yopocho/ESP32_Weather_API/README.md

Repository for creating a new kind of weatherstation for people who are dead-blind.
