yopocho/ESP32_Weather_API/Schematic.pdf

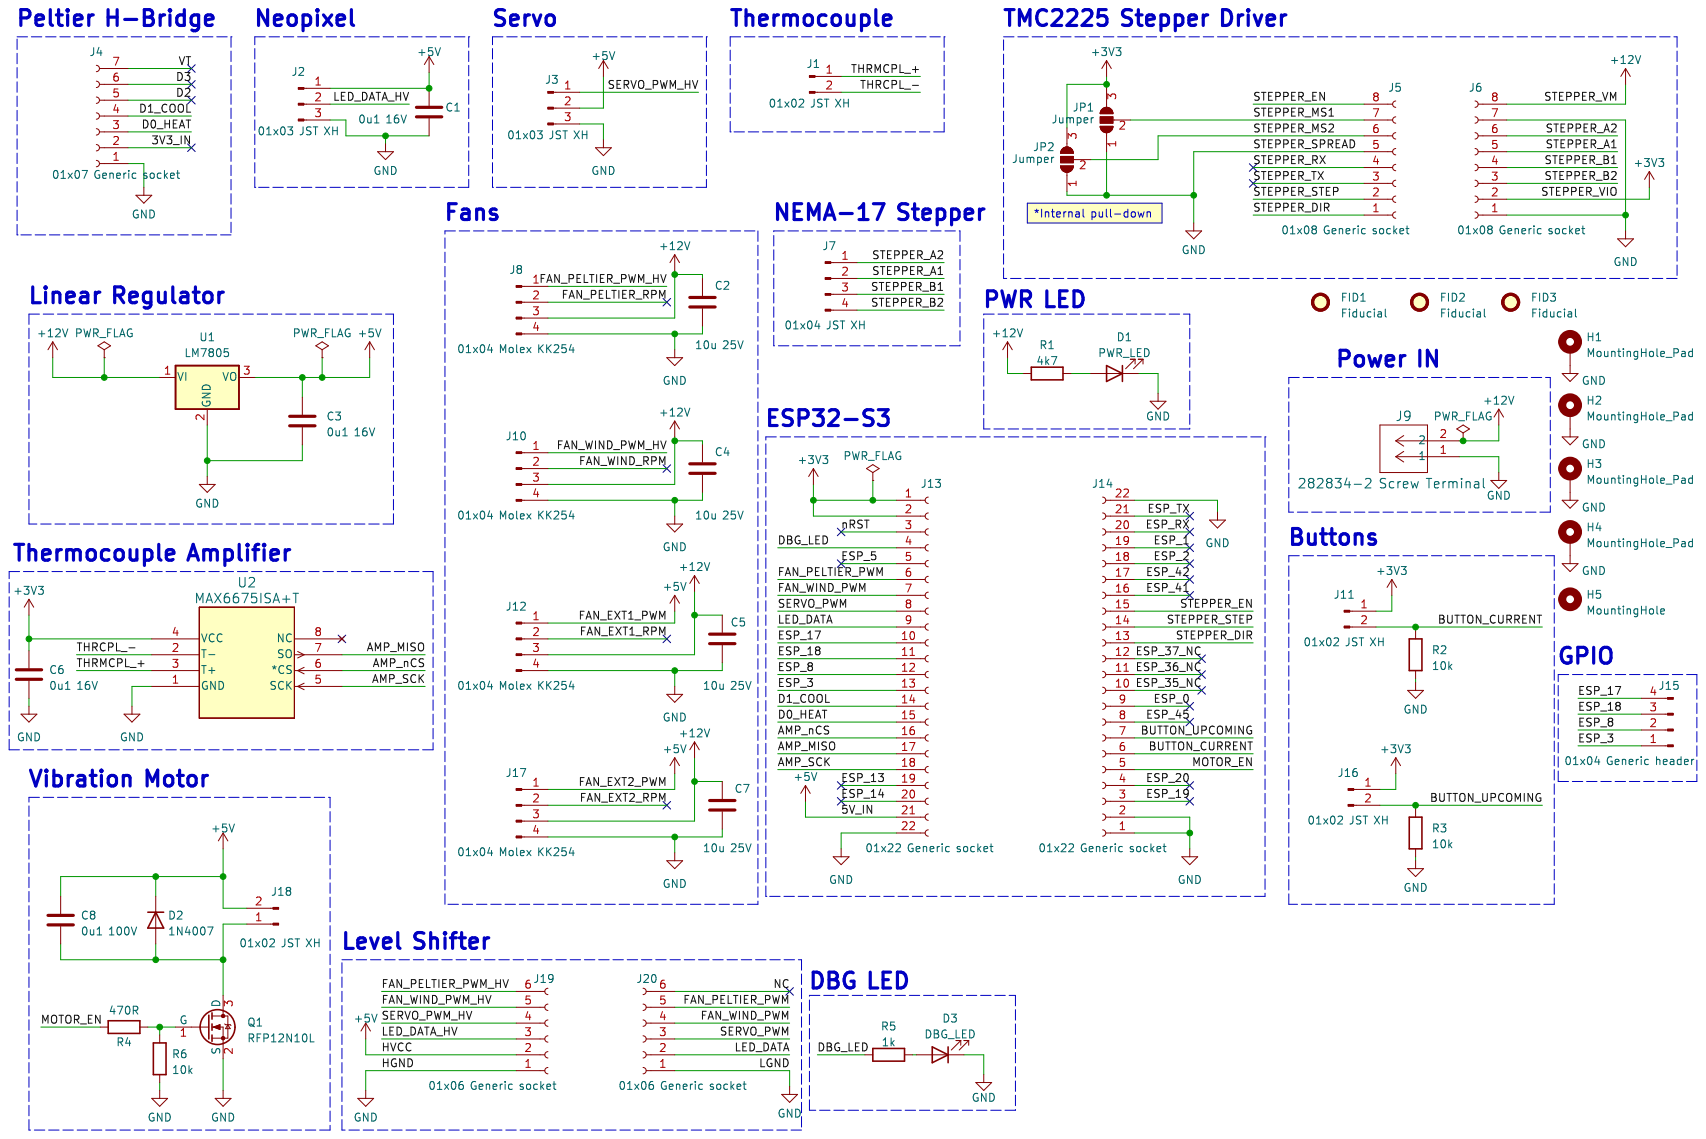
[picture p1: page 1]
