yopocho/ESP32_Weather_API/Layout.pdf

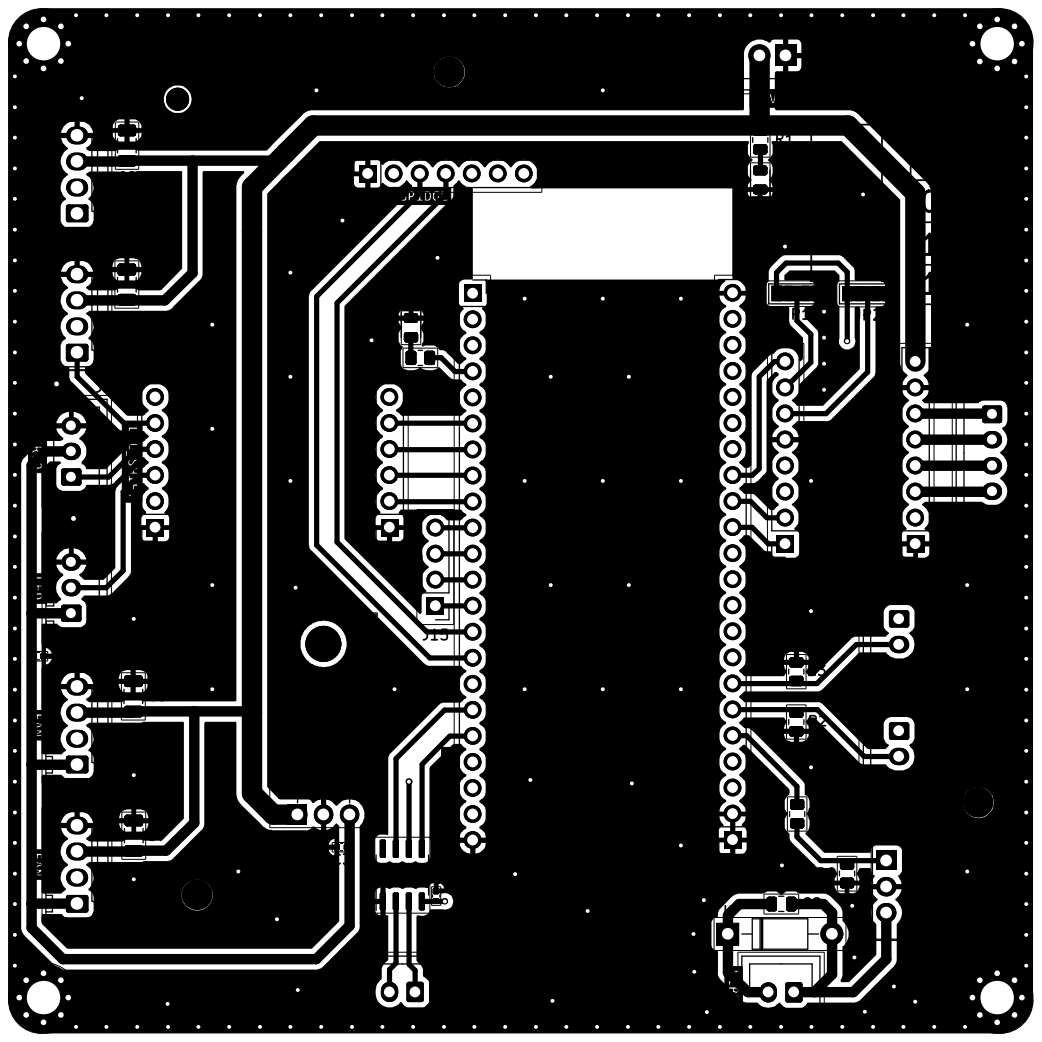
[picture p2: page 1]
