yopocho/ESP32_Weather_API/KiCad/Weatherstation_ESP32S3_Backplane/Weatherstation_ESP32S3_Backplane.kicad_pcb

## KiCad design KiCad/Weatherstation_ESP32S3_Backplane/Weatherstation_ESP32S3_Backplane.kicad_pcb (2023-06-29)

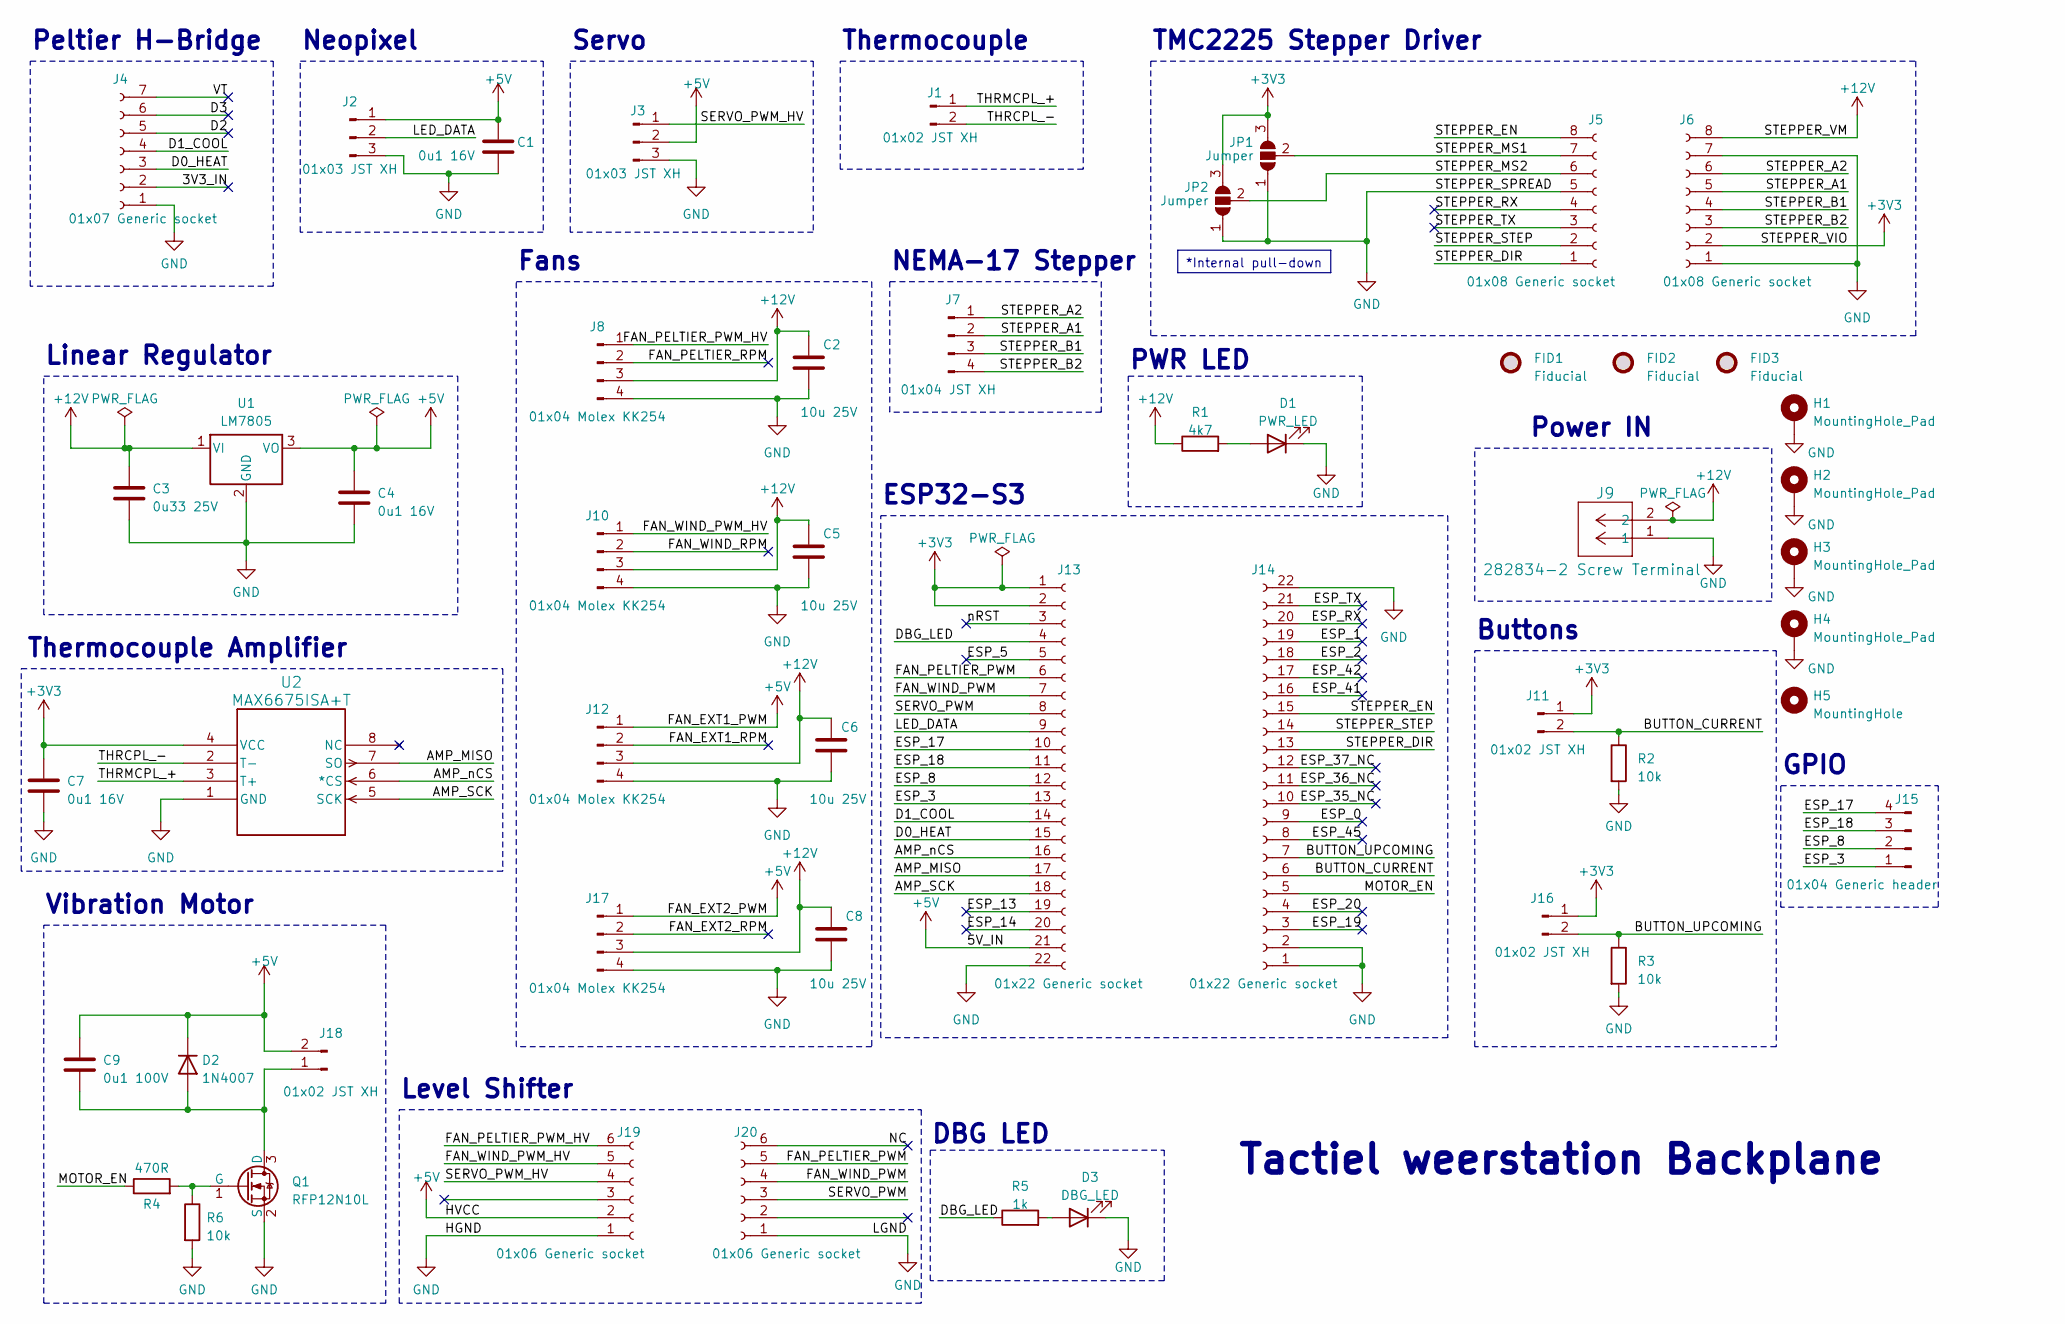
[picture p3: schematic Weatherstation_ESP32S3_Backplane.kicad_sch]

Parts:
C1, C4, C7: 0u1 16V; C_0402_1005Metric; LCSC Part # C1525
C2, C5, C6, C8: 10u 25V; C_1206_3216Metric; LCSC Part # C15850
C3: 0u33 25V; C_1206_3216Metric; LCSC Part # C1525
C9: 0u1 100V; C_0805_2012Metric; LCSC Part # C28233
D1: PWR_LED; LED_0805_2012Metric; LCSC Part # C84256
D2: 1N4007; D_DO-41_SOD81_P10.16mm_Horizontal
D3: DBG_LED; LED_0805_2012Metric; LCSC Part # C84256
FID1, FID2, FID3: Fiducial; Fiducial_1.5mm_Mask3mm
H1, H2, H3, H4: MountingHole_Pad; MountingHole_3.2mm_M3_Pad_Via
H5: MountingHole; MountingHole_2.2mm_M2
J1, J11, J16, J18: 01x02 JST XH; JST_XH_B2B-XH-A_1x02_P2.50mm_Vertical
J2, J3: 01x03 JST XH; JST_XH_B3B-XH-A_1x03_P2.50mm_Vertical
J4: 01x07 Generic socket; PinSocket_1x07_P2.54mm_Vertical
J5, J6: 01x08 Generic socket; PinSocket_1x08_P2.54mm_Vertical
J7: 01x04 JST XH; JST_XH_B4B-XH-A_1x04_P2.50mm_Vertical
J8, J10, J12, J17: 01x04 Molex KK254; Molex_KK-254_AE-6410-04A_1x04_P2.54mm_Vertical
J9: 282834-2 Screw Terminal; TerminalBlock_TE_282834-2_1x02_P2.54mm_Horizontal
J13, J14: 01x22 Generic socket; PinSocket_1x22_P2.54mm_Vertical
J15: 01x04 Generic header; PinHeader_1x04_P2.54mm_Vertical
J19, J20: 01x06 Generic socket; PinSocket_1x06_P2.54mm_Vertical
JP1, JP2: Jumper; SolderJumper-3_P2.0mm_Open_TrianglePad1.0x1.5mm
Q1: RFP12N10L; TO-220-3_Vertical
R1: 4k7; R_0805_2012Metric; LCSC Part # C17673
R2, R3, R6: 10k; R_0805_2012Metric; LCSC Part # C17414
R4: 470R; R_0805_2012Metric; LCSC Part # C17710
R5: 1k; R_0805_2012Metric; LCSC Part # C17673
U1: LM7805; TO-220-3_Horizontal_TabDown
U2: MAX6675ISA+T; SO-8_3.9x4.9mm_P1.27mm; LCSC Part # C16030

Connections:
+3V3: C7.2, J6.2, J11.1, J13.1, J13.2, J16.1, JP1.3 (B), JP2.3 (B), U2.4 (VCC)
+5V: C1.1, C4.1, C9.2, D2.1 (K), J2.1, J3.2, J12.1, J13.21, J17.1, J18.2, J19.2, U1.3 (VO)
+12V: C2.1, C3.1, C5.1, C6.1, C8.1, J6.8, J8.3, J9.2, J10.3, J12.3, J17.3, R1.1, U1.1 (VI)
/3V3_IN: J4.2
/AMP_MISO: J13.17, U2.7 (SO)
/AMP_SCK: J13.18, U2.5 (SCK)
/AMP_nCS: J13.16, U2.6 (*CS)
/BUTTON_CURRENT: J11.2, J14.6, R2.1
/BUTTON_UPCOMING: J14.7, J16.2, R3.1
/D0_HEAT: J4.3, J13.15
/D1_COOL: J4.4, J13.14
/D2: J4.5
/D3: J4.6
/DBG_LED: J13.4, R5.1
/ESP_0: J14.9
/ESP_1: J14.19
/ESP_2: J14.18
/ESP_3: J13.13, J15.1
/ESP_5: J13.5
/ESP_8: J13.12, J15.2
/ESP_13: J13.19
/ESP_14: J13.20
/ESP_17: J13.10, J15.4
/ESP_18: J13.11, J15.3
/ESP_19: J14.3
/ESP_20: J14.4
/ESP_35_NC: J14.10
/ESP_36_NC: J14.11
/ESP_37_NC: J14.12
/ESP_41: J14.16
/ESP_42: J14.17
/ESP_45: J14.8
/ESP_RX: J14.20
/ESP_TX: J14.21
/FAN_EXT1_RPM: J12.2
/FAN_EXT2_RPM: J17.2
/FAN_PELTIER_PWM: J13.6, J20.5
/FAN_PELTIER_PWM_HV: J8.1, J19.6
/FAN_PELTIER_RPM: J8.2
/FAN_WIND_PWM: J13.7, J20.4
/FAN_WIND_PWM_HV: J10.1, J19.5
/FAN_WIND_RPM: J10.2
/LED_DATA: J2.2, J13.9
/MOTOR_EN: J14.5, R4.1
/NC: J20.6
/SERVO_PWM: J13.8, J20.3
/SERVO_PWM_HV: J3.1, J19.4
/STEPPER_A1: J6.5, J7.2
/STEPPER_A2: J6.6, J7.1
/STEPPER_B1: J6.4, J7.3
/STEPPER_B2: J6.3, J7.4
/STEPPER_DIR: J5.1, J14.13
/STEPPER_EN: J5.8, J14.15
/STEPPER_MS1: J5.7, JP1.2 (C)
/STEPPER_MS2: J5.6, JP2.2 (C)
/STEPPER_RX: J5.4
/STEPPER_STEP: J5.2, J14.14
/STEPPER_TX: J5.3
/THRCPL_-: J1.2, U2.2 (T-)
/THRMCPL_+: J1.1, U2.3 (T+)
/VT: J4.7
/nRST: J13.3
unnamed: D1.2 (A), R1.2
unnamed: D3.2 (A), R5.2
unnamed: Q1.1 (G), R4.2, R6.1

Notes on the sheet:
*Internal pull-down
Vibration Motor
ESP32-S3
Linear Regulator
Tactiel weerstation Backplane
Peltier H-Bridge
PWR LED
Level Shifter
Neopixel
Fans
TMC2225 Stepper Driver
Power IN
Thermocouple
NEMA-17 Stepper
Servo
DBG LED
Buttons
Thermocouple Amplifier
GPIO

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
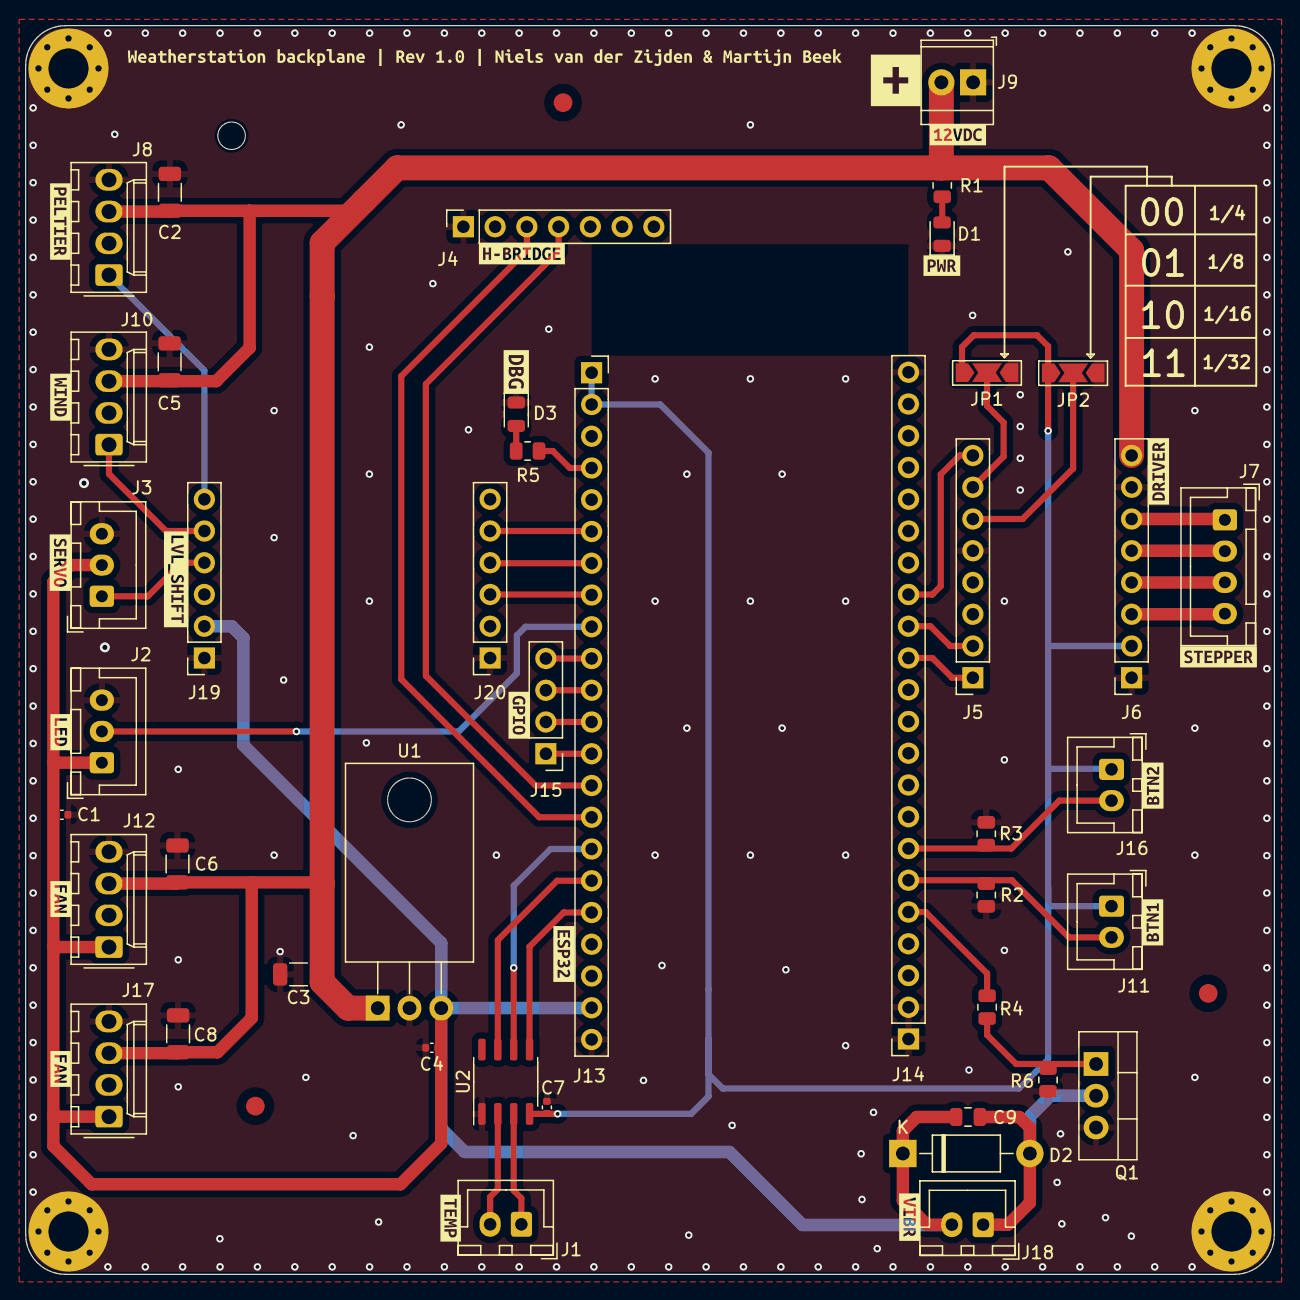
[picture p4: board Weatherstation_ESP32S3_Backplane.kicad_pcb from above]

Board: 2 copper layers, 99.9 x 99.9 mm, 72 parts (0 on the bottom side), 39 nets.

Other parts of the board:
kibuzzard-643E6CEA: G***; kibuzzard-643E6CEA
kibuzzard-643E6CFB: G***; kibuzzard-643E6CFB
kibuzzard-643E6D8F: G***; kibuzzard-643E6D8F
kibuzzard-643E6D39: G***; kibuzzard-643E6D39
kibuzzard-643E6D96: G***; kibuzzard-643E6D96
kibuzzard-643E6DA6: G***; kibuzzard-643E6DA6
kibuzzard-643E6DC2: G***; kibuzzard-643E6DC2
kibuzzard-643FA2B4: G***; kibuzzard-643FA2B4
kibuzzard-6443C6BA: G***; kibuzzard-6443C6BA
kibuzzard-6443C6CC: G***; kibuzzard-6443C6CC
kibuzzard-6443C6EC: G***; kibuzzard-6443C6EC
kibuzzard-6443C8B0: G***; kibuzzard-6443C8B0
kibuzzard-6443C88F: G***; kibuzzard-6443C88F
kibuzzard-6443C714: G***; kibuzzard-6443C714
kibuzzard-6443CDE3: G***; kibuzzard-6443CDE3
kibuzzard-6443CE84: G***; kibuzzard-6443CE84
kibuzzard-6443DBAC: G***; kibuzzard-6443DBAC
kibuzzard-6443FD14: G***; kibuzzard-6443FD14
kibuzzard-6443FD19: G***; kibuzzard-6443FD19
kibuzzard-6446400D: G***; kibuzzard-6446400D
kibuzzard-6446408C: G***; kibuzzard-6446408C
