yopocho/ESP32_Weather_API/src/main.hpp

#ifndef MAIN_HPP_
#define MAIN_HPP_

#include <Arduino.h>
#include <String.h>
#include <WiFi.h>
#include <HTTPClient.h>
#include <ESP32Servo.h>
#include <ArduinoJson.h>
#include <ArduinoBLE.h>
#include <Preferences.h>
#include <AccelStepper.h>
#include <max6675.h>
#include <FastLED.h>
#include "esp_timer.h"
#include "sdkconfig.h"
#include <esp_wifi.h>

#if !defined(CONFIG_BT_ENABLED) || !defined(CONFIG_BLUEDROID_ENABLED)
  #error Bluetooth is not enabled! Please run `make menuconfig` to and enable it
#endif

#define DEBUG
// #define DEBUG_CSV //Outputs free heap in CSV format over serial

#define ERR_NO_DATA "No data returned"
#define ERR_NO_WIFI "No wifi connection established"

#define ERR_INVALID_INPUT "Input object invalid"
#define ERR_INVALID_DATA "Given JSON object does not contain valid data"

#define NOT_SLIPPERY_POS 30
#define SLIGHTLY_SLIPPERY_POS 180
#define QUITE_SLIPPERY_POS 110

#define CHARACTERISTIC_SIZE 512 //BLE

#define JSON_CAPACITY 16192 //Bytes

#define TEMP_TIMEOUT 500 //MAX6675 readout interval

#define WIFI_CONN_TIMEOUT 1000 //reconnection interval

#define FEEDBACK_TIMEOUT 500000//us

#define serviceUUID "1289b0a6-c715-11ed-afa1-0242ac120002"
#define languageCharacteristicUUID "1289b3f8-c715-11ed-afa1-0242ac120002"
#define locationCharacteristicUUID "1289b81c-c715-11ed-afa1-0242ac120002"
#define temperatureCharacteristicUUID "fc4971a2-fec6-11ed-be56-0242ac120002"
#define precipitationCharacteristicUUID "fc4973e6-fec6-11ed-be56-0242ac120002"
#define windspeedCharacteristicUUID "fc4975a8-fec6-11ed-be56-0242ac120002"
#define slipperinessCharacteristicUUID "fc497724-fec6-11ed-be56-0242ac120002"
#define trainingEnableCharacteristicUUID "5fd4fca6-feee-11ed-be56-0242ac120002"
#define displayTimeoutCharacteristicUUID "e1341012-0384-11ee-be56-0242ac120002"
#define WiFiSSIDCharacteristicUUID "0da27fd2-044b-11ee-be56-0242ac120002"
#define WiFiPasswordCharacteristicUUID "e1340d92-0384-11ee-be56-0242ac120002"
#define upcomingWeatherCharacteristicUUID "460caff2-0453-11ee-be56-0242ac120002"

#define STEPPER_MAX_SPEED 6400
#define STEPPER_MIN_SPEED 400
#define STEPPER_TARGET_POS 180 //steps

#define MAX_RAIN_HOURLY 10 //mm
#define MAX_SNOW_HOURLY 100 //mm

#define RAIN_FLAG true
#define SNOW_FLAG false 

#define MAX_PELTIER_TEMP 45
#define MIN_PELTIER_TEMP 10

/* Weatherstation data-entry */
class weatherstationObject //Contains default values
{
  private:
    const String key = "63463198104ddccafc13815f6d61e642"; //API Key voor OpenWeather
  public:
    const uint32_t APITimeout = 1500000; //ms
    float measuredTemp = 20.0f;
    float targetTemp = 20.0f; 
    uint32_t timeout = 60000; //ms
    const String endpointCurrent = "http://api.openweathermap.org/data/2.5/weather?";
    const String endpoint3hour5days = "http://api.openweathermap.org/data/2.5/forecast?";
    String lattitude = "0.0000";
    String longitude = "0.0000";
    String language = "nl";
    String units = "metric";
    String stepCount = "1";
    String callOpenWeatherMapAPI(String endpoint);
    String SSID = "NA";
    String password = "NA";
};
weatherstationObject weatherStation;

typedef struct
{
  private:
  public:
  int weatherID = 0;
  String weatherDescription = "";
  float windChillTemperature = 0.0;
  float actualTemperature = 0.0;
  float windSpeed = 0.0;
  float rainLevel = 0.0;
  float snowLevel = 0.0;
} weatherReportObject;
weatherReportObject weatherReportCurrent, weatherReportUpcoming, weatherReportTraining;

/* MAX6675 Thermocouple def. */
const int thermocoupleCLK = 12;
const int thermocoupleCS = 10;
const int thermocoupleMISO = 11;
MAX6675 thermocouple(thermocoupleCLK, thermocoupleCS, thermocoupleMISO);

/* Pin def. for heatsink fan control */
const int peltierFanPWMPin = 6;
const int peltierFanPWMChannel = 1;
const int fanPWMFrequency = 25000; // Fans require 25kHz
const int fanPWMResolution = 8; // bits

/* Pin def. for wind fan control */
const int windFanPWMPin = 7;
const int windFanPWMChannel = 2;

/* Pin def. for peltier H-Bridge */
const int peltierHeat = 9;
const int peltierCool = 46;

/* Pin def. for Neopixel data */
const int neopixelPin = 16;
CRGB statusNeoPixel[1];
bool flagStatusLED = false;

/* Pin def. servo */
const int servoPin = 15;
Servo slipperinessDiscServo;

/* Precipitation Stepper */
const int directionPin = 38; 
const int stepPin = 39; 
const int enablePin = 40; 
AccelStepper stepper(AccelStepper::DRIVER, stepPin, directionPin);

/* Pin def. User Interface Buttons */
const int buttonCurrentWeather = 47;
const int buttonUpcomingWeather = 48;
const float tempHysteresis = 0.5;

/* Pin def. vibration motor */
const int motorEnable = 21;
bool feedbackFlag = true;
esp_timer_handle_t timerFeedbackTimeout;

/* API Time-out timer */
uint32_t previousMillisAPI = 0;

/* Temperature time-out timer */
uint32_t previousMillisTemp = 0;

/* Wifi time-out timer */
uint32_t previousMillisWifi = 0;

/* Feedback time-out timer */
uint32_t previousMillisButtonpress = 0;

/* Timed processes */
esp_timer_handle_t timerWeatherFlags;
volatile bool flagCurrentWeather = false;
volatile bool flagUpcomingWeather = false;
volatile bool flagTrainingWeather = false;
volatile bool flagFault = false;

/* Millis delay */
uint32_t previousMillis = 0;

/* Bluetooth */
BLEService weatherstationService(serviceUUID); // create service
BLEStringCharacteristic languageCharacteristic        (languageCharacteristicUUID,        BLERead | BLEWrite | BLENotify, CHARACTERISTIC_SIZE);
BLEStringCharacteristic locationCharacteristic        (locationCharacteristicUUID,        BLERead | BLEWrite | BLENotify, CHARACTERISTIC_SIZE);
BLEStringCharacteristic temperatureCharacteristic     (temperatureCharacteristicUUID,     BLERead | BLEWrite | BLENotify, CHARACTERISTIC_SIZE);
BLEStringCharacteristic precipitationCharaceristic    (precipitationCharacteristicUUID,   BLERead | BLEWrite | BLENotify, CHARACTERISTIC_SIZE);
BLEStringCharacteristic windspeedCharacteristic       (windspeedCharacteristicUUID,       BLERead | BLEWrite | BLENotify, CHARACTERISTIC_SIZE);
BLEStringCharacteristic slipperinessCharacteristic    (slipperinessCharacteristicUUID,    BLERead | BLEWrite | BLENotify, CHARACTERISTIC_SIZE);
BLEStringCharacteristic trainingEnableCharacteristic  (trainingEnableCharacteristicUUID,  BLERead | BLEWrite | BLENotify, CHARACTERISTIC_SIZE);
BLEStringCharacteristic WifiSSIDCharactaristic        (WiFiSSIDCharacteristicUUID,        BLERead | BLEWrite | BLENotify, CHARACTERISTIC_SIZE);
BLEStringCharacteristic WiFiPasswordCharacteristic    (WiFiPasswordCharacteristicUUID,    BLERead | BLEWrite | BLENotify, CHARACTERISTIC_SIZE);
BLEStringCharacteristic displayTimeoutCharacteristic  (displayTimeoutCharacteristicUUID,  BLERead | BLEWrite | BLENotify, CHARACTERISTIC_SIZE);
BLEStringCharacteristic upcomingWeatherCharacteristic (upcomingWeatherCharacteristicUUID, BLERead | BLEWrite | BLENotify, CHARACTERISTIC_SIZE);

/* EEPROM */
Preferences preferences;

/* Task handle for multi-core utilization for stepper */
TaskHandle_t stepperTask;

/* One time event flag */
bool doOnceFlag = false;

/* Function prototypes */
void setup();
void loop();
void setLocation(String location);
void setLanguage(String language);
void setWindSpeedFan(float windSpeed);
float mapFloat(float x, float in_min, float in_max, float out_min, float out_max);
void setStepperSpeed(float precipitationAmount, int maxPrecipitationHourly);
void setStatusLED(CRGB color);
void WifiConnected(WiFiEvent_t event, WiFiEventInfo_t info);
void WifiDisconnected(WiFiEvent_t event, WiFiEventInfo_t info);
void wifiInit(void);
void IRAM_ATTR ISRFeedbackTimeout(void *arg);

/* Function definitions */
String weatherstationObject::callOpenWeatherMapAPI(String endpoint)
{
  if ((WiFi.status() == WL_CONNECTED)) 
  { //Check the current connection status

    HTTPClient http;

    String combinedEndpoint =  endpoint + "lang=" + weatherStation.language + '&' + "lat=" + weatherStation.lattitude + '&' + "lon=" + weatherStation.longitude + '&' + "units=" + weatherStation.units + '&' + "appid=" + weatherStation.key;
    if(endpoint.indexOf("forecast")) combinedEndpoint = combinedEndpoint + '&' + "cnt=" + weatherStation.stepCount;

    #ifdef DEBUG
      Serial.print("Endpoint: ");
      Serial.println(combinedEndpoint);
    #endif

    http.begin(combinedEndpoint); //Specify the URL
    int httpCode = http.GET();  //Make the request

    if (httpCode > 0) //Check for the returning code
    { 
        String payload = http.getString();
        http.end(); //Free the resources
        return payload;
    }
    else 
    {
      http.end(); //Free the resources
      return ERR_NO_DATA;  
    }  
  }
  return ERR_NO_WIFI;
}


int initGPIO()
{
    /* Peltier setup */
  pinMode(peltierCool, OUTPUT);
  pinMode(peltierHeat, OUTPUT);
  pinMode(buttonCurrentWeather, INPUT);
  pinMode(buttonUpcomingWeather, INPUT);

  ledcSetup(peltierFanPWMChannel, fanPWMFrequency, fanPWMResolution);
  ledcAttachPin(peltierFanPWMPin, peltierFanPWMChannel);

  /* Wind setup */
  ledcSetup(windFanPWMChannel, fanPWMFrequency, fanPWMResolution);
  ledcAttachPin(windFanPWMPin, windFanPWMChannel);

  /* Init servo */
	ESP32PWM::allocateTimer(2);
  slipperinessDiscServo.setPeriodHertz(50);
  if(!slipperinessDiscServo.attach(servoPin)) return -1;
  pinMode(enablePin, OUTPUT);

  /* Init vibration motor */
  pinMode(motorEnable, OUTPUT);

  return 1;
}


DynamicJsonDocument parseJSON(String payload)
{
  DynamicJsonDocument weatherReport(JSON_CAPACITY);

  DeserializationError error = deserializeJson(weatherReport, payload);

  #ifdef DEBUG
    if (error) {
      Serial.print(F("deserializeJson() failed: "));
      Serial.println(error.f_str());
    }
  #endif

  return weatherReport;
}


void controlLoop(float temp)
{
  bool higherFlag = false;
  bool lowerFlag = false;

  if(temp > weatherStation.targetTemp + tempHysteresis) lowerFlag = true;
  else if(temp < weatherStation.targetTemp - tempHysteresis) higherFlag = true;
  else
  {
    higherFlag = false;
    lowerFlag = false;
  }

  if (higherFlag)
  {
    digitalWrite(peltierCool, LOW);
    digitalWrite(peltierHeat, HIGH);
    ledcWrite(peltierFanPWMChannel, 0);
    higherFlag = false;
  }
  else if (lowerFlag)
  {
    digitalWrite(peltierHeat, LOW);
    digitalWrite(peltierCool, HIGH);
    ledcWrite(peltierFanPWMChannel, 255);
    lowerFlag = false;
  }
  else if(!lowerFlag && !higherFlag)
  {
    digitalWrite(peltierCool, LOW);
    digitalWrite(peltierHeat, LOW);
    digitalWrite(peltierFanPWMPin, LOW); 
    if(feedbackFlag) {
      #ifdef DEBUG
        Serial.println("Peltier at set temperature");
      #endif
      digitalWrite(motorEnable, HIGH);
      esp_timer_start_once(timerFeedbackTimeout, FEEDBACK_TIMEOUT);
      feedbackFlag = false;
    }
    setStatusLED(CRGB::Green);
  }
}


int updateTemperature()
{
  weatherStation.measuredTemp = thermocouple.readCelsius();
  if(weatherStation.measuredTemp <= (MIN_PELTIER_TEMP - 5.0) || weatherStation.measuredTemp >= MAX_PELTIER_TEMP + 8.0) {
    setStatusLED(CRGB::Red);
    flagUpcomingWeather = false;
    flagCurrentWeather = false;
    flagTrainingWeather = false;
    flagFault = true;
    return 0;
  }
  #ifdef DEBUG
    Serial.print("Measured temperature: ");
    Serial.print(weatherStation.measuredTemp);
    Serial.println("ºC");
  #endif

  #ifdef DEBUG_CSV
    /* Here for the timer :) */
    Serial.print("Available heap in bytes,");
    Serial.println(ESP.getFreeHeap());
  #endif

  return 1;
}


int setSlipperinessServo(int weatherID)
{
  /* Levels of slipperiness and their respective position on the tactile disc servo */
  uint16_t notSlippery = NOT_SLIPPERY_POS;
  uint16_t slightlySlippery = SLIGHTLY_SLIPPERY_POS;
  uint16_t quiteSlippery = QUITE_SLIPPERY_POS;

  switch(weatherID)
  {
    case 200:
    case 201:
    case 202:
    case 210:
    case 211:
    case 212:
    case 230:
    case 231:
    case 232:
    case 300:
    case 301:
    case 302:
    case 310:
    case 311:
    case 312:
    case 313:
    case 314:
    case 321:
    case 500:
    case 501:
    case 502:
    case 503:
    case 511:
    case 520:
    case 521:
    case 522:
    case 531:
      slipperinessDiscServo.write(slightlySlippery); //We define all rain as slightly slippery here (TBD)
      #ifdef DEBUG
        Serial.println("Setting disc to slightly slippery");
      #endif
      break;
    case 600:
    case 601:
    case 602:
    case 611:
    case 612:
    case 613:
    case 615:
    case 616:
    case 620:
    case 621:
    case 622:
      slipperinessDiscServo.write(quiteSlippery); //We define all snow here as quite slippery
      #ifdef DEBUG
        Serial.println("Setting disc to quite slippery");
      #endif
      break;
    case 701:
    case 711:
    case 721:
    case 731:
    case 741:
    case 751:
    case 761:
    case 762:
    case 771:
    case 781:
    case 800:
    case 801:
    case 802:
    case 803:
    case 804:
      slipperinessDiscServo.write(notSlippery);
      #ifdef DEBUG
        Serial.println("Setting disc to not slippery");
      #endif
      break;
    default:
      return -1;
      break;
  } 
  return 1;
}


void getSmoothness(void)
{

}


bool APITimeout(uint32_t delayAmount)
{
  uint32_t timeoutMillis = delayAmount;
  uint32_t currentMillis = millis();
  if (currentMillis > (previousMillisAPI + timeoutMillis))
  {
    previousMillisAPI = currentMillis;
    return true;
  }
  else return false;
}

bool tempTimeout(uint32_t delayAmount)
{
  uint32_t timeoutMillis = delayAmount;
  uint32_t currentMillis = millis();
  if (currentMillis > (previousMillisTemp + timeoutMillis))
  {
    previousMillisTemp = currentMillis;
    return true;
  }
  else return false;
}


bool wiFiConnectionTimeout(uint32_t delayAmount) {
  uint32_t timeoutMillis = delayAmount;
  uint32_t currentMillis = millis();
  if (currentMillis > (previousMillisWifi + timeoutMillis))
  {
    previousMillisWifi = currentMillis;
    return true;
  }
  else return false;
}

uint16_t getWeatherID(DynamicJsonDocument weatherReport)
{
  int weatherID = 0;
  String weatherStrings[3];
  int stringIterator = 0;
  JsonArray weatherArray;

  if((weatherReport["cnt"].as<int>() == weatherStation.stepCount.toInt()) && (weatherReport["cod"].as<int>() == 200)) // Upcoming weather
  {
    int adjustedStepCount = weatherStation.stepCount.toInt() - 1;
    weatherArray = weatherReport["list"][adjustedStepCount]["weather"];
  }
  else if (((weatherReport["coord"]["lat"].as<float>() != 0.0f) || (weatherReport["coord"]["lon"].as<float>() != 0.0f)) && (weatherReport["cod"].as<int>() == 200)) // Current weather
  {
    weatherArray = weatherReport["weather"].as<JsonArray>();
  }
  
  stringIterator = 0;
  for (JsonObject a : weatherArray) 
  {
    for (JsonPair kv : a) 
    {
        if(kv.value().is<int>()) weatherID = kv.value().as<int>();
        else weatherStrings[stringIterator++] = kv.value().as<const char*>();
    }
  }

  /* Ensure freeing of memory */
  weatherArray.clear();

  return weatherID;
}


String getWeatherDescription(DynamicJsonDocument weatherReport)
{
  JsonArray weatherArray;

  if((weatherReport["cnt"].as<int>() == weatherStation.stepCount.toInt()) && (weatherReport["cod"].as<int>() == 200)) // Upcoming weather
  {
    int adjustedStepCount = weatherStation.stepCount.toInt() - 1;
    weatherArray = weatherReport["list"][adjustedStepCount]["weather"];
  }
  else if (((weatherReport["coord"]["lat"].as<float>() != 0.0f) || (weatherReport["coord"]["lon"].as<float>() != 0.0f)) && (weatherReport["cod"].as<int>() == 200)) // Current weather
  {
    weatherArray = weatherReport["weather"].as<JsonArray>();
  }

  String weatherStrings[3];
  int stringIterator = 0;

  for (JsonObject a : weatherArray) 
  {
    for (JsonPair kv : a) 
    {
      // if(kv.key() == ID) return kv.value().as<const char*>();
      if(kv.value().is<int>());
      else weatherStrings[stringIterator++] = kv.value().as<const char*>();
    }
  }

  /* Ensure freeing of memory */
  weatherArray.clear();

  if(weatherStrings[1] != NULL) return weatherStrings[1];
  return ERR_INVALID_DATA;
}


float getRainLevel(DynamicJsonDocument weatherReport)
{
  if((weatherReport["cnt"].as<int>() == weatherStation.stepCount.toInt()) && (weatherReport["cod"].as<int>() == 200)) // Upcoming weather
  {
    int adjustedStepCount = weatherStation.stepCount.toInt() - 1;
    return weatherReport["list"][adjustedStepCount]["rain"]["3h"];
  }
  else if (((weatherReport["coord"]["lat"].as<float>() != 0.0f) || (weatherReport["coord"]["lon"].as<float>() != 0.0f)) && (weatherReport["cod"].as<int>() == 200)) // Current weather
  {
    return weatherReport["rain"]["1h"];
  }
  return -1.0f;
}


float getSnowLevel(DynamicJsonDocument weatherReport)
{
  if((weatherReport["cnt"].as<int>() == weatherStation.stepCount.toInt()) && (weatherReport["cod"].as<int>() == 200)) // Upcoming weather
  {
    int adjustedStepCount = weatherStation.stepCount.toInt() - 1;
    return weatherReport["list"][adjustedStepCount]["snow"]["3h"];
  }
  else if (((weatherReport["coord"]["lat"].as<float>() != 0.0f) || (weatherReport["coord"]["lon"].as<float>() != 0.0f)) && (weatherReport["cod"].as<int>() == 200)) // Current weather
  {
    return weatherReport["snow"]["1h"];
  }
  return -1.0f;
}


float getWindSpeed(DynamicJsonDocument weatherReport)
{
  if((weatherReport["cnt"].as<int>() == weatherStation.stepCount.toInt()) && (weatherReport["cod"].as<int>() == 200)) // Upcoming weather
  {
    int adjustedStepCount = weatherStation.stepCount.toInt() - 1;
    return weatherReport["list"][adjustedStepCount]["wind"]["speed"];
  }
  else if (((weatherReport["coord"]["lat"].as<float>() != 0.0f) || (weatherReport["coord"]["lon"].as<float>() != 0.0f)) && (weatherReport["cod"].as<int>() == 200)) // Current weather
  {
    return weatherReport["wind"]["speed"];
  }
  return -1.0f;
}


void dataHandlerLanguageCharacteristic(BLEDevice central, BLECharacteristic characteristic) {
  String language = languageCharacteristic.value();
  #ifdef DEBUG
    Serial.print("Characteristic event, written: ");
    Serial.println(language);
  #endif
  preferences.putString("Language", language);
  weatherStation.language = preferences.getString("Language", "NaN");
  #ifdef DEBUG
    Serial.print("New language: ");
    Serial.println(preferences.getString("Language", "NaN"));
  #endif
}


void dataHandlerTemperatureCharacteristic(BLEDevice central, BLECharacteristic characteristic) {
  String trainingTargetTemp = temperatureCharacteristic.value();
  #ifdef DEBUG
    Serial.print("Characteristic event, written: ");
    Serial.println(trainingTargetTemp);
  #endif
  weatherReportTraining.windChillTemperature = trainingTargetTemp.toFloat();
}


void dataHandlerPrecipitationCharacteristic(BLEDevice central, BLECharacteristic characteristic) {
  String trainingPrecipitation = precipitationCharaceristic.value();
  #ifdef DEBUG
    Serial.print("Characteristic event, written: ");
    Serial.println(trainingPrecipitation);
  #endif
  weatherReportTraining.rainLevel = trainingPrecipitation.toFloat();
}


void dataHandlerWindspeedCharacteristic(BLEDevice central, BLECharacteristic characteristic) {
  String trainingWindspeed = windspeedCharacteristic.value();
  #ifdef DEBUG
    Serial.print("Characteristic event, written: ");
    Serial.println(trainingWindspeed);
  #endif
  weatherReportTraining.windSpeed = trainingWindspeed.toFloat();
}


void dataHandlerSlipperinessCharacteristic(BLEDevice central, BLECharacteristic characteristic) {
  String trainingSlipperiness = slipperinessCharacteristic.value();
  #ifdef DEBUG
    Serial.print("Characteristic event, written: ");
    Serial.println(trainingSlipperiness);
  #endif
  weatherReportTraining.weatherID = trainingSlipperiness.toInt();
}


void dataHandlerTrainingEnableCharacteristic(BLEDevice central, BLECharacteristic characteristic) {
  /* Update countdown in mobile app with real value */
  displayTimeoutCharacteristic.writeValue(String(weatherStation.timeout));

  /* Disable precipitation stepper */
  digitalWrite(enablePin, HIGH);
  vTaskSuspend(stepperTask);

  flagTrainingWeather = true;
  flagCurrentWeather = false;
  flagUpcomingWeather = false;
  doOnceFlag = true;
  esp_timer_stop(timerWeatherFlags);
  esp_timer_start_once(timerWeatherFlags, weatherStation.timeout * 1000);
  setStatusLED(CRGB::DarkOrange);
  #ifdef DEBUG
    Serial.print("Starting trainingmode for ");
    Serial.print(weatherStation.timeout);
    Serial.println("ms");
  #endif
}


void dataHandlerLocationCharacteristic(BLEDevice central, BLECharacteristic characteristic) {
  String location = locationCharacteristic.value();
  #ifdef DEBUG
    Serial.print("Characteristic event, written: ");
    Serial.println(location);
  #endif
  setLocation(location);
}


void dataHandlerWifiSSIDCharacteristic(BLEDevice central, BLECharacteristic characteristic) {
  String WiFiSSID = WifiSSIDCharactaristic.value();
  preferences.putString("SSID", WiFiSSID);
  weatherStation.SSID = preferences.getString("SSID", "Niels hotspot");
  #ifdef DEBUG
    Serial.print("Characteristic event, written: ");
    Serial.println(WiFiSSID);
    Serial.print("New SSID: ");
    Serial.println(weatherStation.SSID);
  #endif
}

void dataHandlerWiFiPasswordCharacteristic(BLEDevice central, BLECharacteristic characteristic) {
  String WiFiPassword = WiFiPasswordCharacteristic.value();
  preferences.putString("Password", WiFiPassword);
  weatherStation.password = preferences.getString("Password", "Ikwilkaas");
  #ifdef DEBUG
    Serial.print("Characteristic event, written: ");
    Serial.println(WiFiPassword);
    Serial.print("New Password: ");
    Serial.println(weatherStation.password);
  #endif
  wifiInit();
  delay(5000);
  preferences.putBool("wifi_possible", true);
}

void dataHandlerDisplayTimeoutCharacteristic(BLEDevice central, BLECharacteristic characteristic) {
  String displayTimeout = displayTimeoutCharacteristic.value();
  preferences.putInt("timeout_integer", displayTimeout.toInt() * 1000);
  uint32_t tempDisplayTimeout = preferences.getInt("timeout_integer", 10000);
  weatherStation.timeout = tempDisplayTimeout;
  #ifdef DEBUG
    Serial.print("Characteristic event, written: ");
    Serial.println(displayTimeout);
    Serial.print("New display timeout: ");
    Serial.println(weatherStation.timeout);
  #endif
}

void dataHandlerUpcomingWeatherCharacteristic(BLEDevice central, BLECharacteristic characteristic) {
  String upcomingWeatherStepAmount = upcomingWeatherCharacteristic.value();
  preferences.putString("stepCount", upcomingWeatherStepAmount);
  String tempUpcomingWeatherStepAmount = preferences.getString("stepCount", "1");
  weatherStation.stepCount = tempUpcomingWeatherStepAmount.toInt();
  #ifdef DEBUG
    Serial.print("Characteristic event, written: ");
    Serial.println(upcomingWeatherStepAmount);
    Serial.print("New upcoming weather stepcount: ");
    Serial.println(weatherStation.stepCount);
  #endif
}


void setLocation(String location)
{
  preferences.putString("Lattitude", location.substring(0, location.indexOf(',')));
  preferences.putString("Longitude", location.substring((location.indexOf(',') + 1), (location.length() - 1)));
  weatherStation.lattitude = preferences.getString("Lattitude", "0.0000");
  weatherStation.longitude = preferences.getString("Longitude", "0.0000");
  #ifdef DEBUG
    Serial.print("New lattitude: ");
    Serial.println(preferences.getString("Lattitude", "NaN"));
    Serial.print("New longitude: ");
    Serial.println(preferences.getString("Longitude", "NaN"));
  #endif
}


void connectHandlerBLE(BLEDevice central) {
  #ifdef DEBUG
    Serial.print("Connected event, central: ");
    Serial.println(central.address());
  #endif
  displayTimeoutCharacteristic.writeValue("0");
}


void disconnectHandlerBLE(BLEDevice central) {
  #ifdef DEBUG
    Serial.print("Disconnected event, central: ");
    Serial.println(central.address());
  #endif
}


bool initBLE()
{
  BLE.setLocalName("Tactiel Weerstation");
  BLE.setAdvertisedService(weatherstationService);
  weatherstationService.addCharacteristic(languageCharacteristic);
  weatherstationService.addCharacteristic(locationCharacteristic);
  weatherstationService.addCharacteristic(temperatureCharacteristic);
  weatherstationService.addCharacteristic(precipitationCharaceristic);
  weatherstationService.addCharacteristic(windspeedCharacteristic);
  weatherstationService.addCharacteristic(slipperinessCharacteristic);
  weatherstationService.addCharacteristic(trainingEnableCharacteristic);
  weatherstationService.addCharacteristic(WifiSSIDCharactaristic);
  weatherstationService.addCharacteristic(WiFiPasswordCharacteristic);
  weatherstationService.addCharacteristic(displayTimeoutCharacteristic);
  weatherstationService.addCharacteristic(upcomingWeatherCharacteristic);
  BLE.setEventHandler(BLEConnected, connectHandlerBLE);
  BLE.setEventHandler(BLEDisconnected, disconnectHandlerBLE);
  languageCharacteristic.setEventHandler(BLEWritten, dataHandlerLanguageCharacteristic);
  locationCharacteristic.setEventHandler(BLEWritten, dataHandlerLocationCharacteristic);
  temperatureCharacteristic.setEventHandler(BLEWritten, dataHandlerTemperatureCharacteristic);
  precipitationCharaceristic.setEventHandler(BLEWritten, dataHandlerPrecipitationCharacteristic);
  windspeedCharacteristic.setEventHandler(BLEWritten, dataHandlerWindspeedCharacteristic);
  slipperinessCharacteristic.setEventHandler(BLEWritten, dataHandlerSlipperinessCharacteristic);
  trainingEnableCharacteristic.setEventHandler(BLEWritten, dataHandlerTrainingEnableCharacteristic);
  WifiSSIDCharactaristic.setEventHandler(BLEWritten, dataHandlerWifiSSIDCharacteristic);
  WiFiPasswordCharacteristic.setEventHandler(BLEWritten, dataHandlerWiFiPasswordCharacteristic);
  displayTimeoutCharacteristic.setEventHandler(BLEWritten, dataHandlerDisplayTimeoutCharacteristic);
  upcomingWeatherCharacteristic.setEventHandler(BLEWritten, dataHandlerUpcomingWeatherCharacteristic);
  BLE.addService(weatherstationService);
  BLE.advertise();
  return true;
}


float getWindChillTemperature(DynamicJsonDocument weatherReport)
{
  if((weatherReport["cnt"].as<int>() == weatherStation.stepCount.toInt()) && (weatherReport["cod"].as<int>() == 200)) // Upcoming weather
  {
    int adjustedStepCount = weatherStation.stepCount.toInt() - 1;
    return weatherReport["list"][adjustedStepCount]["main"]["feels_like"];
  }
  else if (((weatherReport["coord"]["lat"].as<float>() != 0.0f) || (weatherReport["coord"]["lon"].as<float>() != 0.0f)) && (weatherReport["cod"].as<int>() == 200)) // Current weather
  {
    return weatherReport["main"]["feels_like"];
  }
  return -273.15f;
}


void IRAM_ATTR ISRWeatherFlags(void *arg)
{
  flagCurrentWeather = false;
  flagUpcomingWeather = false;
  flagTrainingWeather = false;
  flagStatusLED = true;
  #ifdef DEBUG
    Serial.println("---------------Finished displaying the weather---------------");
  #endif
}


void IRAM_ATTR ISRFeedbackTimeout(void *arg) 
{
  digitalWrite(motorEnable, LOW);
}

void initTimers()
{
  esp_timer_create_args_t timerWeatherFlagsArgs = {};
  esp_timer_create_args_t timerFeedbackTimeoutArgs = {};
  timerWeatherFlagsArgs.callback = &ISRWeatherFlags;
  timerFeedbackTimeoutArgs.callback = &ISRFeedbackTimeout;
  esp_timer_create(&timerWeatherFlagsArgs, &timerWeatherFlags);
  esp_timer_create(&timerFeedbackTimeoutArgs, &timerFeedbackTimeout);
}


void idle()
{
  /* Ensure peltier is off */
  if(digitalRead(peltierCool)) digitalWrite(peltierCool, LOW);
  if(digitalRead(peltierHeat)) digitalWrite(peltierHeat, LOW);
  ledcWrite(peltierFanPWMChannel, 0);

  /* Disable precipitation stepper */
  digitalWrite(enablePin, HIGH);
  vTaskSuspend(stepperTask);

  /* Disable wind */
  ledcWrite(windFanPWMChannel, 0);

  /* Update flag(s) */
  doOnceFlag = false;

  /* Set Status LED */
  if(flagStatusLED) 
  {
    digitalWrite(motorEnable, HIGH);
    esp_timer_start_once(timerFeedbackTimeout, FEEDBACK_TIMEOUT*6);
    setStatusLED(CRGB::Green);
    flagStatusLED = false;
  }
}


void displayPrecipitation(void *pvParameters)
{
  #ifdef DEBUG
    Serial.print("Task for driving steppermotor running on core ");
    Serial.println(xPortGetCoreID());
  #endif
  while(true)
  {
    Serial.println("Moving the stepper");
    if(stepper.maxSpeed() > 0.0) {
      stepper.moveTo(STEPPER_TARGET_POS);
      stepper.runToPosition();
      stepper.moveTo(-STEPPER_TARGET_POS);
      stepper.runToPosition();
    }
  }
}


void displayWeather(weatherReportObject *weatherReport)
{ 
  /* Handle temperature */
  weatherStation.targetTemp = mapFloat(weatherReport->windChillTemperature, -10, 40, MIN_PELTIER_TEMP, MAX_PELTIER_TEMP);
  controlLoop(weatherStation.measuredTemp);

  /* Handle events that only need to happen once per buttonpress */
  if(doOnceFlag)
  {
    /* Trigger vibration feedback motor */
    digitalWrite(motorEnable, HIGH);
    feedbackFlag = true;

    #ifdef DEBUG
      Serial.print("Send data to displayTimeout characteristic: ");
      Serial.println(weatherStation.timeout);
    #endif

    #ifdef DEBUG
      Serial.println("Now displaying this weather:");
      Serial.print("Amount of time:");
      Serial.println(weatherStation.timeout);
    #endif

    /* Handle wind */
    setWindSpeedFan(weatherReport->windSpeed);

    /* Handle precipitation info */
    if((weatherReport->rainLevel > 0.0001f) || (weatherReport->snowLevel > 0.0001f)) { //Small value to negate float weirdness
      float highestPrecipitation = (weatherReport->rainLevel < weatherReport->snowLevel) ? SNOW_FLAG : RAIN_FLAG;
      if(highestPrecipitation == RAIN_FLAG) setStepperSpeed(weatherReport->rainLevel, MAX_RAIN_HOURLY);
      else if(highestPrecipitation == SNOW_FLAG) setStepperSpeed(weatherReport->snowLevel, MAX_SNOW_HOURLY);
      #ifdef DEBUG
        Serial.println("Starting the stepper task");
      #endif
      digitalWrite(enablePin, LOW);
      vTaskResume(stepperTask);
    }
    else {
      stepper.setMaxSpeed(0);
      digitalWrite(enablePin, HIGH);
      vTaskSuspend(stepperTask);
    }


    /* Handle slipperiness */
    if (!setSlipperinessServo(weatherReport->weatherID)) 
    {
      #ifdef DEBUG
        Serial.println("Error: weatherID not valid");
      #endif
    }

    #ifdef DEBUG
      Serial.print("Set targetTemp: ");
      Serial.println(weatherStation.targetTemp);
    #endif

    /* Disable vibration feedback motor */
    digitalWrite(motorEnable, LOW);

    doOnceFlag = false;
  }
}

void setStepperSpeed(float precipitationAmount, int maxPrecipitationHourly)
{
  uint16_t stepperSpeed = mapFloat(precipitationAmount, 0, maxPrecipitationHourly, STEPPER_MIN_SPEED, STEPPER_MAX_SPEED);
  if(precipitationAmount == 0.00) stepperSpeed = 0;
  stepper.setMaxSpeed(stepperSpeed);
  #ifdef DEBUG
    Serial.print("Set stepper speed to: ");
    Serial.println(stepperSpeed);
  #endif
} 

void updateWeatherReports()
{
  String weatherCurrentString = weatherStation.callOpenWeatherMapAPI(weatherStation.endpointCurrent);
  DynamicJsonDocument weatherCurrentJSON(JSON_CAPACITY);
  weatherCurrentJSON = parseJSON(weatherCurrentString);
  weatherReportCurrent.weatherID = getWeatherID(weatherCurrentJSON);
  weatherReportCurrent.weatherDescription = getWeatherDescription(weatherCurrentJSON);
  weatherReportCurrent.windChillTemperature = getWindChillTemperature(weatherCurrentJSON); //Gevoelstemperatuur heeft de meeste relevantie
  weatherReportCurrent.rainLevel = getRainLevel(weatherCurrentJSON);
  weatherReportCurrent.windSpeed = getWindSpeed(weatherCurrentJSON);
  weatherReportCurrent.snowLevel = getSnowLevel(weatherCurrentJSON);
  
  String weatherUpcomingString = weatherStation.callOpenWeatherMapAPI(weatherStation.endpoint3hour5days);
  DynamicJsonDocument weatherUpcomingJSON(JSON_CAPACITY);
  weatherUpcomingJSON = parseJSON(weatherUpcomingString);
  weatherReportUpcoming.weatherID = getWeatherID(weatherUpcomingJSON);
  weatherReportUpcoming.weatherDescription = getWeatherDescription(weatherUpcomingJSON);
  weatherReportUpcoming.windChillTemperature = getWindChillTemperature(weatherUpcomingJSON);
  weatherReportUpcoming.rainLevel = getRainLevel(weatherUpcomingJSON);
  weatherReportUpcoming.windSpeed = getWindSpeed(weatherUpcomingJSON);
  weatherReportUpcoming.snowLevel = getSnowLevel(weatherUpcomingJSON);

  #ifdef DEBUG
    Serial.println("-----Current weather-----");
    Serial.println(weatherCurrentString);
    Serial.print("\nWeather ID: ");
    Serial.println(weatherReportCurrent.weatherID);
    Serial.print("Het huidige weer is: ");
    Serial.println(weatherReportCurrent.weatherDescription);
    Serial.print("De gevoelstemperatuur is: ");
    Serial.println(weatherReportCurrent.windChillTemperature);
    Serial.print("De windsnelheid is: ");
    Serial.println(weatherReportCurrent.windSpeed);
    Serial.print("De neerslag is: ");
    Serial.println(weatherReportCurrent.rainLevel);
    Serial.print("De sneeuw is: ");
    Serial.println(weatherReportCurrent.snowLevel);

    int timeInterval = weatherStation.stepCount.toInt();
    timeInterval *= 3;
    Serial.println("\n-----Upcoming weather-----");
    Serial.println(weatherUpcomingString);
    Serial.print("\nHet weer over ");
    Serial.print(timeInterval);
    Serial.println(" uur");
    Serial.print("Weather ID: ");
    Serial.println(weatherReportUpcoming.weatherID);
    Serial.print("het opkomende weer zal zijn: ");
    Serial.println(weatherReportUpcoming.weatherDescription);
    Serial.print("De gevoelstemperatuur zal zijn: ");
    Serial.println(weatherReportUpcoming.windChillTemperature);
    Serial.print("De windsnelheid zal zijn: ");
    Serial.println(weatherReportUpcoming.windSpeed);
    Serial.print("De neerslag zal zijn: ");
    Serial.println(weatherReportUpcoming.rainLevel);
    Serial.print("De sneeuw zal zijn: ");
    Serial.println(weatherReportUpcoming.snowLevel);
  #endif

  /* Ensure freeing of memory */
  weatherCurrentJSON.clear();
  weatherUpcomingJSON.clear();
}

float mapFloat(float x, float in_min, float in_max, float out_min, float out_max)
{
 return (x - in_min) * (out_max - out_min) / (in_max - in_min) + out_min;
}

void setWindSpeedFan(float windSpeed)
{ 
  uint32_t fanPWM = (uint32_t)round(mapFloat(windSpeed, 0.0, 10.0, 0, 255));
  ledcWrite(windFanPWMChannel, fanPWM);
  #ifdef DEBUG
    Serial.print("Set Wind-fan PWM to: ");
    Serial.print((int)(((float)fanPWM)/255*100));
    Serial.println("%");
  #endif
}

void setStatusLED(CRGB color)
{
  statusNeoPixel[0] = color;
  FastLED.show();
  FastLED.setBrightness(255);
}

void WifiConnected(WiFiEvent_t event, WiFiEventInfo_t info)
{
  #ifdef DEBUG
    Serial.println("Connected to the WiFi network");
  #endif
}

void WifiDisconnected(WiFiEvent_t event, WiFiEventInfo_t info)
{
  #ifdef DEBUG
    Serial.println("Wifi connection lost...");
  #endif

  setStatusLED(CRGB::DarkOrange);
}

void wifiInit(void) {
  WiFi.begin(weatherStation.SSID.c_str(), weatherStation.password.c_str());
  WiFi.onEvent(WifiConnected, ARDUINO_EVENT_WIFI_STA_CONNECTED);
  WiFi.onEvent(WifiDisconnected, ARDUINO_EVENT_WIFI_STA_DISCONNECTED);
}

#endif
