yopocho/ESP32_Weather_API/(commit log)

2023-04-23 Tracking KiCad
    [Weatherstation_ESP32S3_Backplane.kicad_pcb, Weatherstation_ESP32S3_Backplane.kicad_sch]
2023-04-23 modified: .gitignore, added KiCad stuff
2023-04-23 Edited 3D-model of ESP32 to better get a sense of the finished product
    [Weatherstation_ESP32S3_Backplane.kicad_pcb]
2023-04-23 Changed trackwidth of 3.3V to 1mm
    [Weatherstation_ESP32S3_Backplane.kicad_pcb]
2023-04-23 Changed the HU-logo from silkscreen to soldermask punch-out
    [Weatherstation_ESP32S3_Backplane.kicad_pcb]
2023-04-23 Moved HU-logo
    [Weatherstation_ESP32S3_Backplane.kicad_pcb]
2023-04-23 KiCad: Added origin for drill and placement files
    [Weatherstation_ESP32S3_Backplane.kicad_pcb]
2023-04-24 Moved from BS18D20 to MAX6675 thermocouple.
    [Weatherstation_ESP32S3_Backplane.kicad_pcb, Weatherstation_ESP32S3_Backplane.kicad_sch]
2023-04-24 Added DBG_LED, flat-mount LM7805, GPIO breakout header
    [Weatherstation_ESP32S3_Backplane.kicad_pcb, Weatherstation_ESP32S3_Backplane.kicad_sch]
2023-04-24 Finished PCB
    [Weatherstation_ESP32S3_Backplane.kicad_pcb]
2023-04-24 Generated production files
    [Weatherstation_ESP32S3_Backplane-B_Cu.gbr, Weatherstation_ESP32S3_Backplane-B_Mask.gbr, Weatherstation_ESP32S3_Backplane-B_Paste.gbr, Weatherstation_ESP32S3_Backplane-B_Silkscreen.gbr, Weatherstation_ESP32S3_Backplane-Edge_Cuts.gbr, Weatherstation_ESP32S3_Backplane-F_Cu.gbr, Weatherstation_ESP32S3_Backplane-F_Mask.gbr, Weatherstation_ESP32S3_Backplane-F_Paste.gbr]
2023-04-24 Added the stepper code to core 0 (parallel process)
2023-05-01 Mapped windspeed to fan PWM, added doOnceFlag for all weather besides temp
2023-05-01 Changed 3D-model of fan headers to represent correct part. Footprint & symbol needs to be changed at a later time/at the end to correct mistake made during design process.
    [Weatherstation_ESP32S3_Backplane.kicad_pcb]
2023-05-30 Did too much too explain..
    [main.cpp, main.hpp]
2023-06-20 Added QoL and stability features
    [Weatherstation_ESP32S3_Backplane.kicad_sch]
2023-06-26 Please be the final fix, MARTIJN
    [main.cpp, main.hpp]
2023-06-26 Removed an if-check to make the feedback motor work again -_-
2023-06-29 Fixed known issues with PCB: Connected neopixel directly to ESP32, not through level shifter; Exchanged drain & source of vibration motor MOSFET; Added 0,33uF MLCC between pin 1 and gnd of LM7805;
    [Weatherstation_ESP32S3_Backplane.kicad_pcb, Weatherstation_ESP32S3_Backplane.kicad_sch]
